DangKhoa2210/Digital-Microfluidics/Kicad Library/KiCadLibrary/arduino_micro_shield-master/README.md

arduino_micro_shield
====================

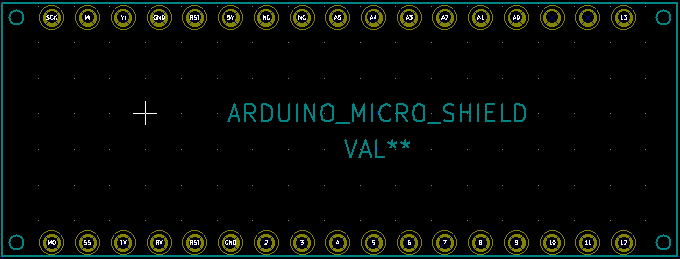
[picture p1: Kicad Library/KiCadLibrary/arduino_micro_shield-master/arduino_micro_shield.png]
My image


KiCAD library and footprint for an Arduino Micro shield.

This is a component which represent the Arduino Micro pinout,
and a footprint for that component which maps to the surface area
and pinout of the Micro.

Pull requests very welcome!
