DangKhoa2210/Digital-Microfluidics/DMF_V2/Electronics/1. Mainboard/Mainboard_V2.kicad_pcb

## KiCad design DMF_V2/Electronics/1. Mainboard/Mainboard_V2.kicad_pcb (2025-07-13)

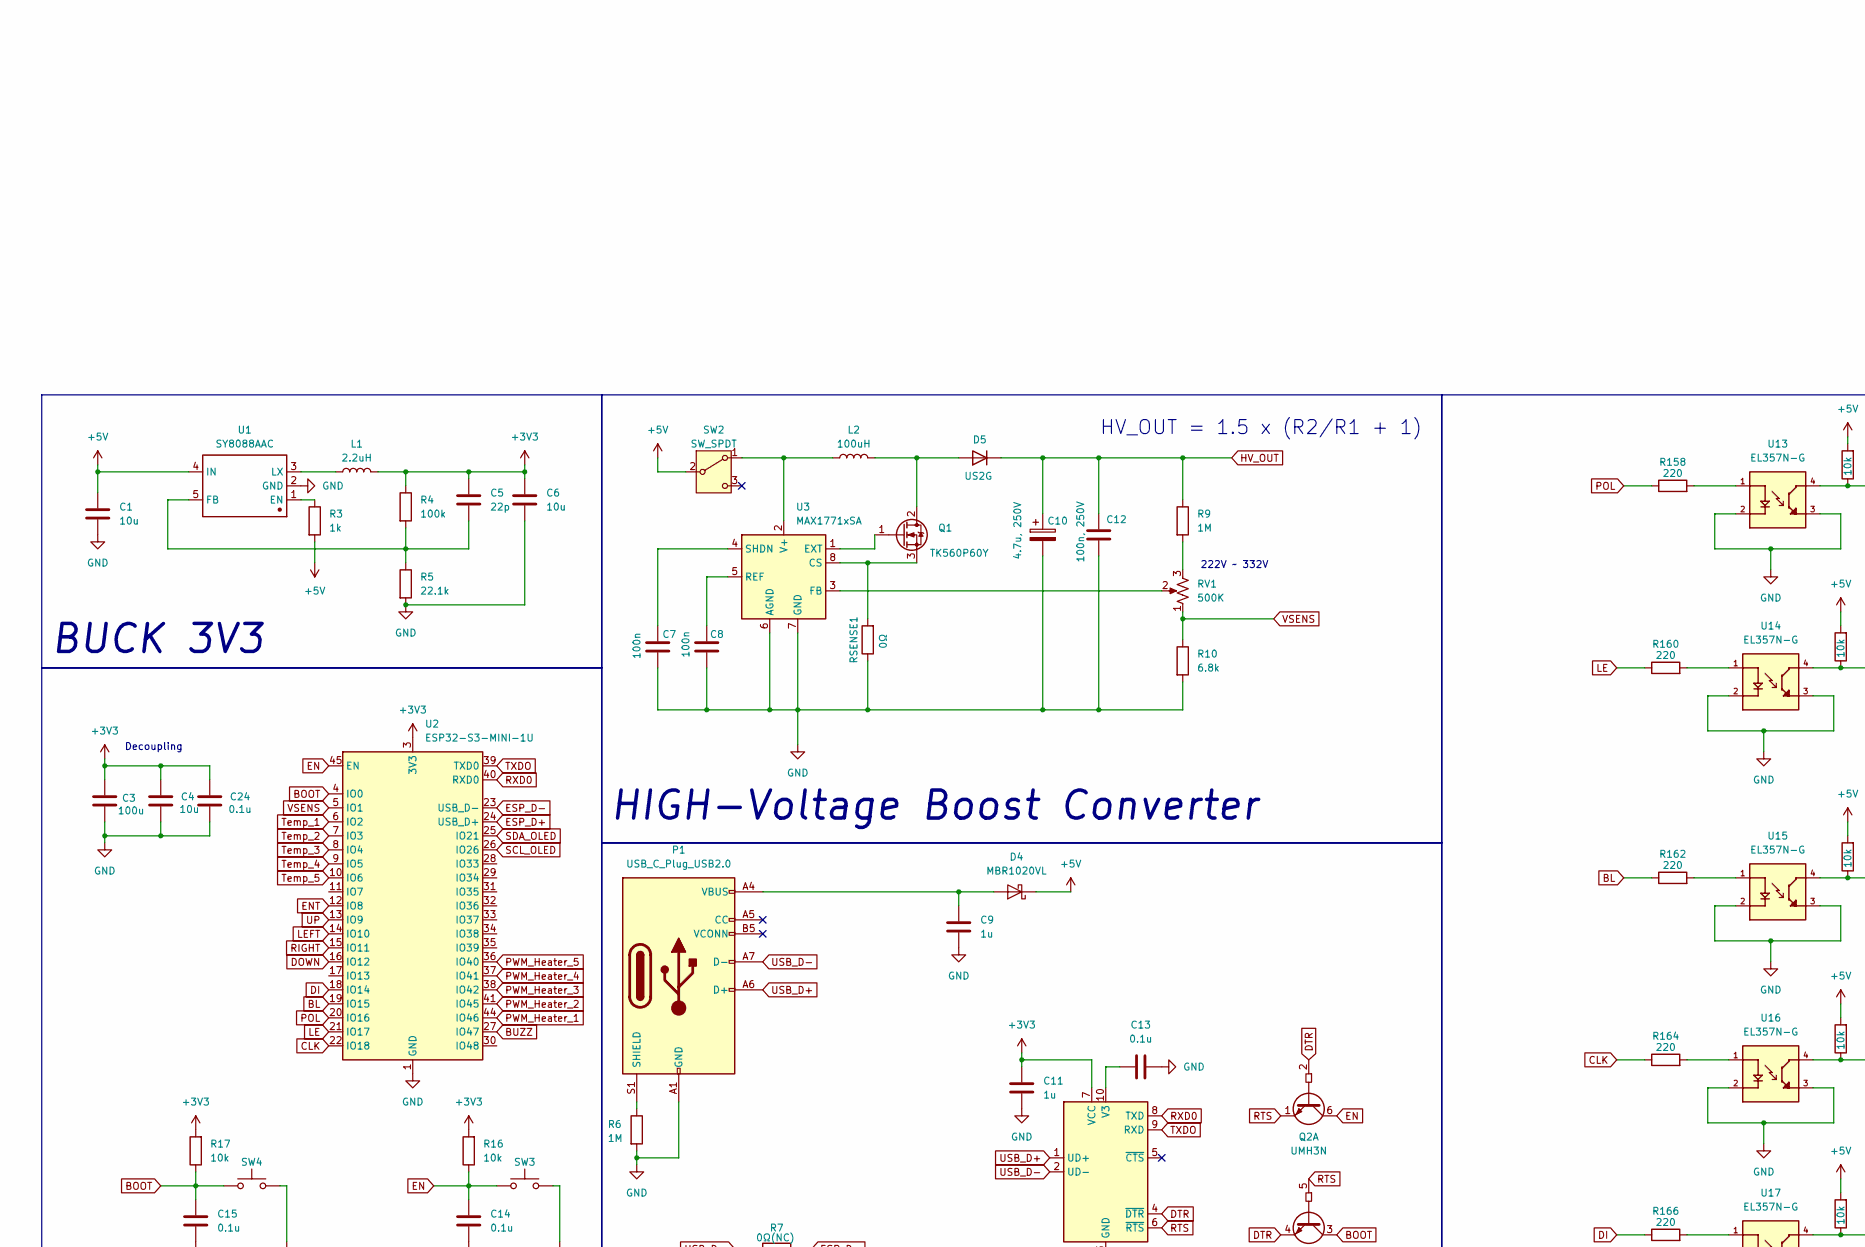
[picture p2: schematic Mainboard_V2.kicad_sch, part in row 1, column 1]

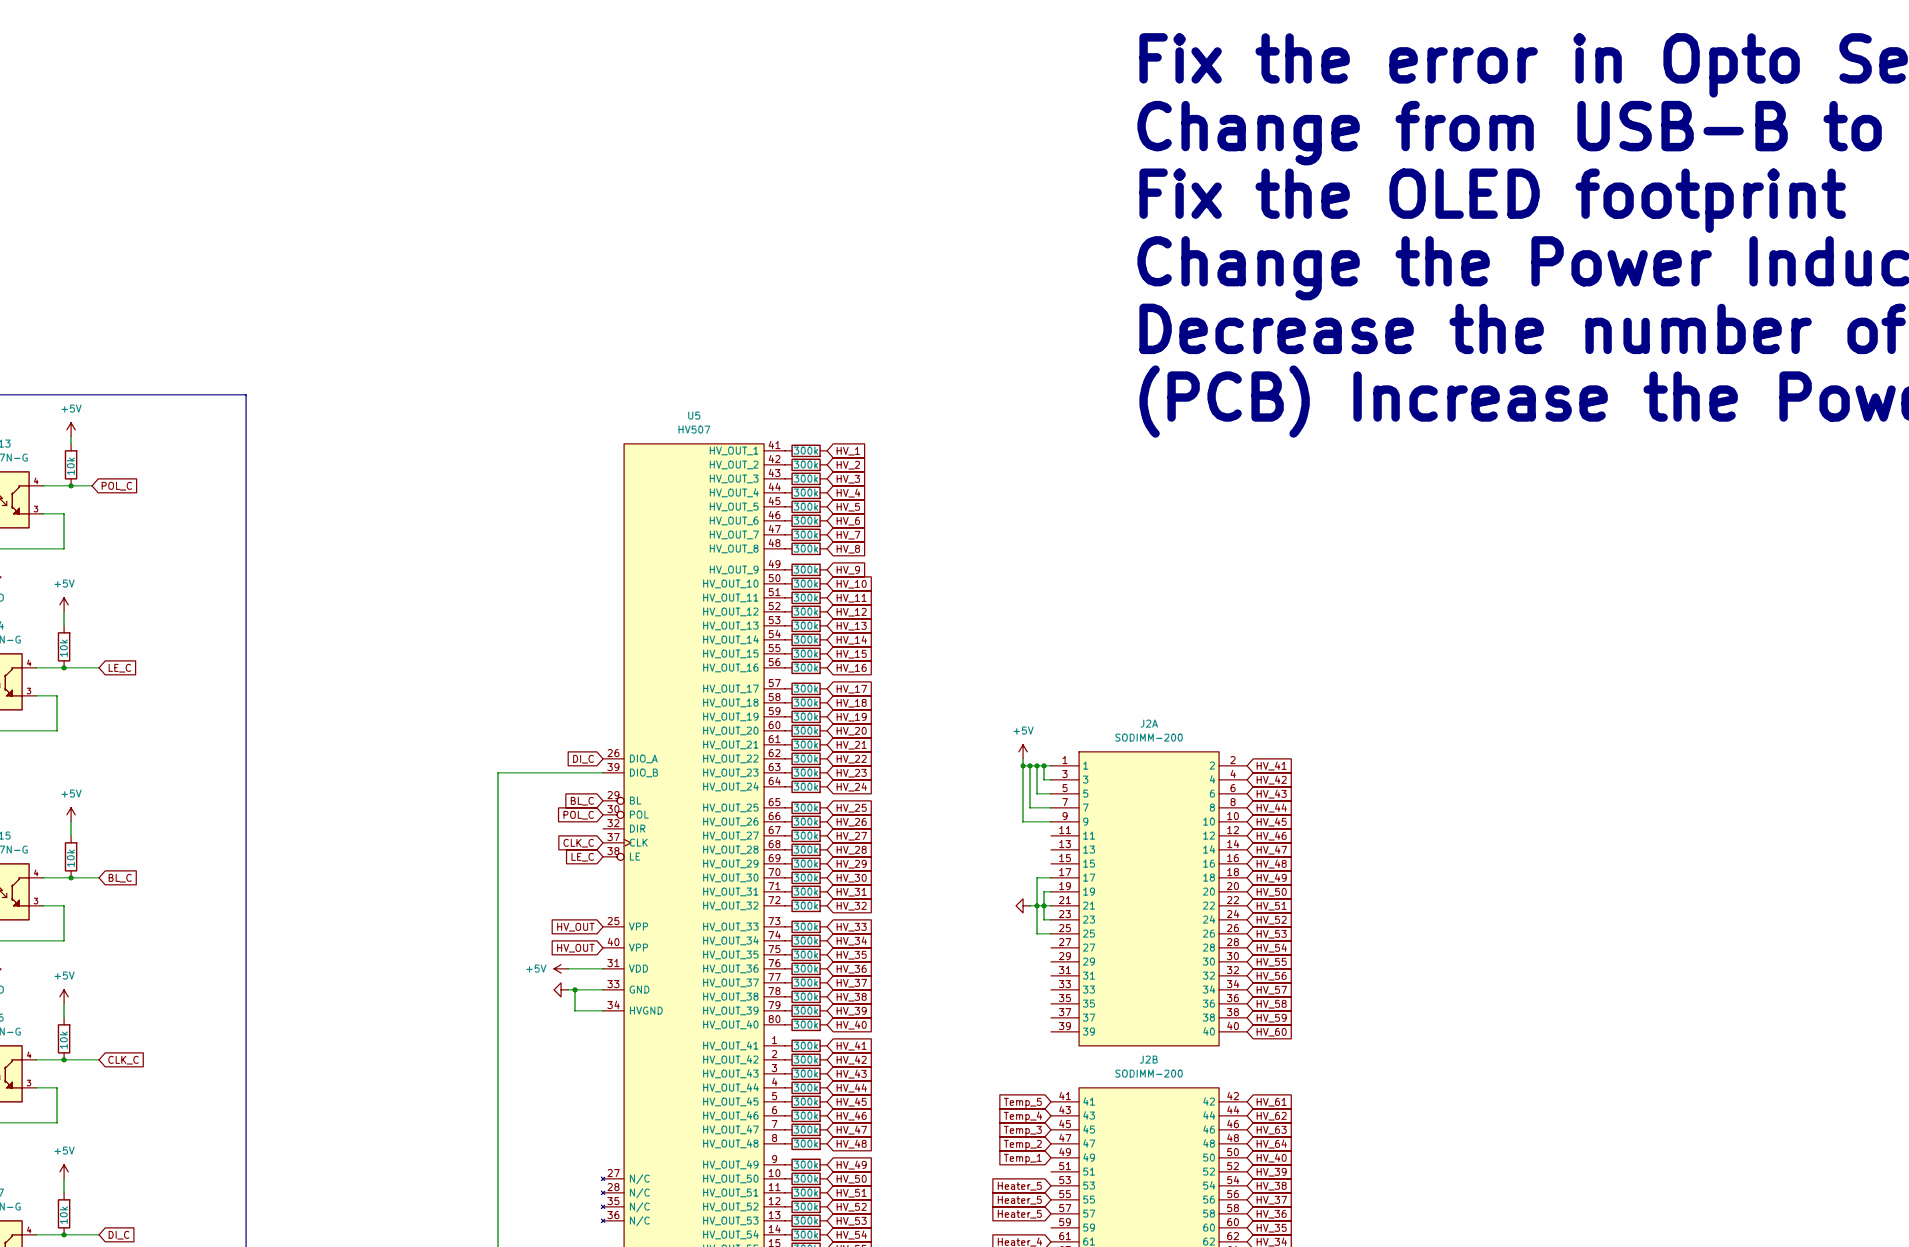
[picture p3: schematic Mainboard_V2.kicad_sch, part in row 1, column 2]

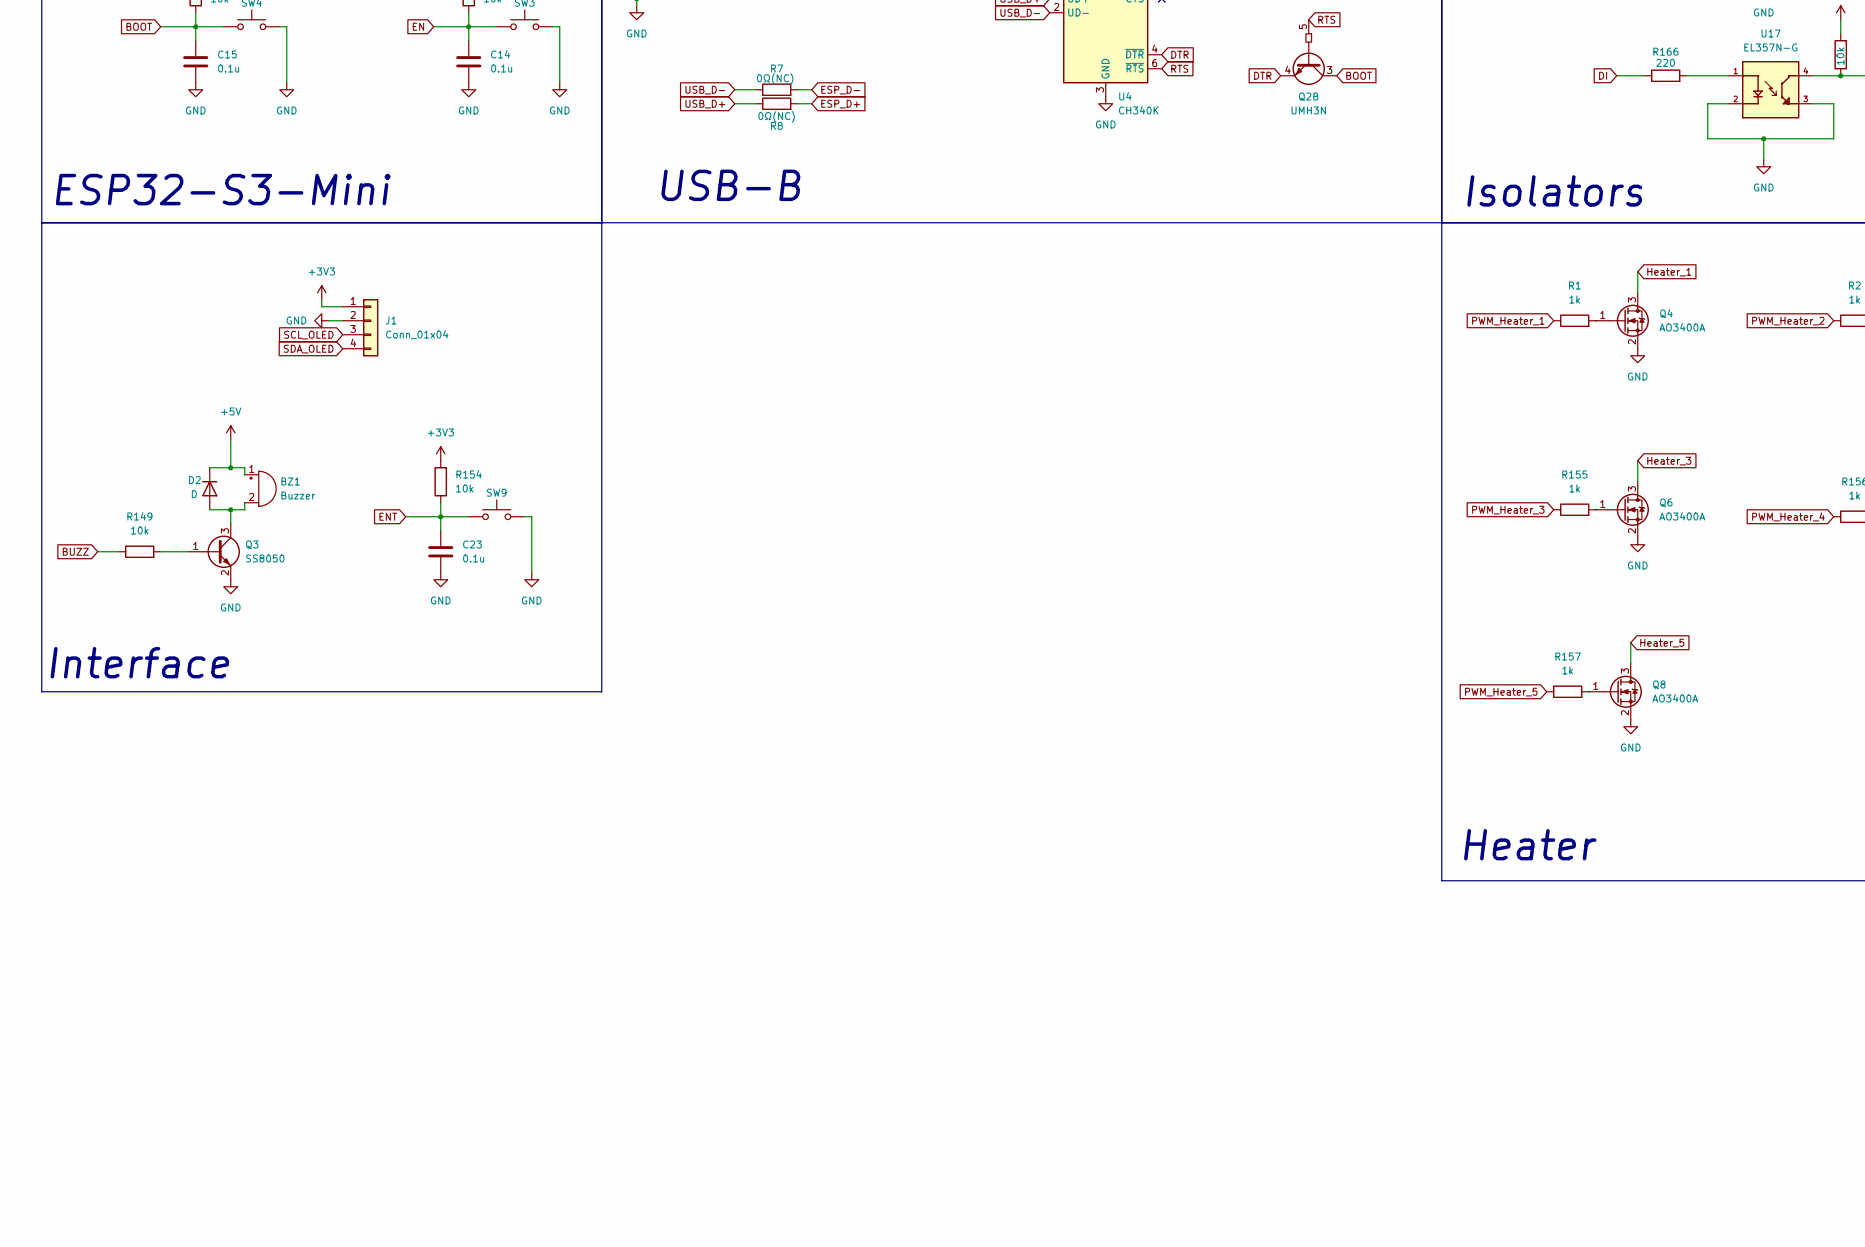
[picture p4: schematic Mainboard_V2.kicad_sch, part in row 2, column 1]

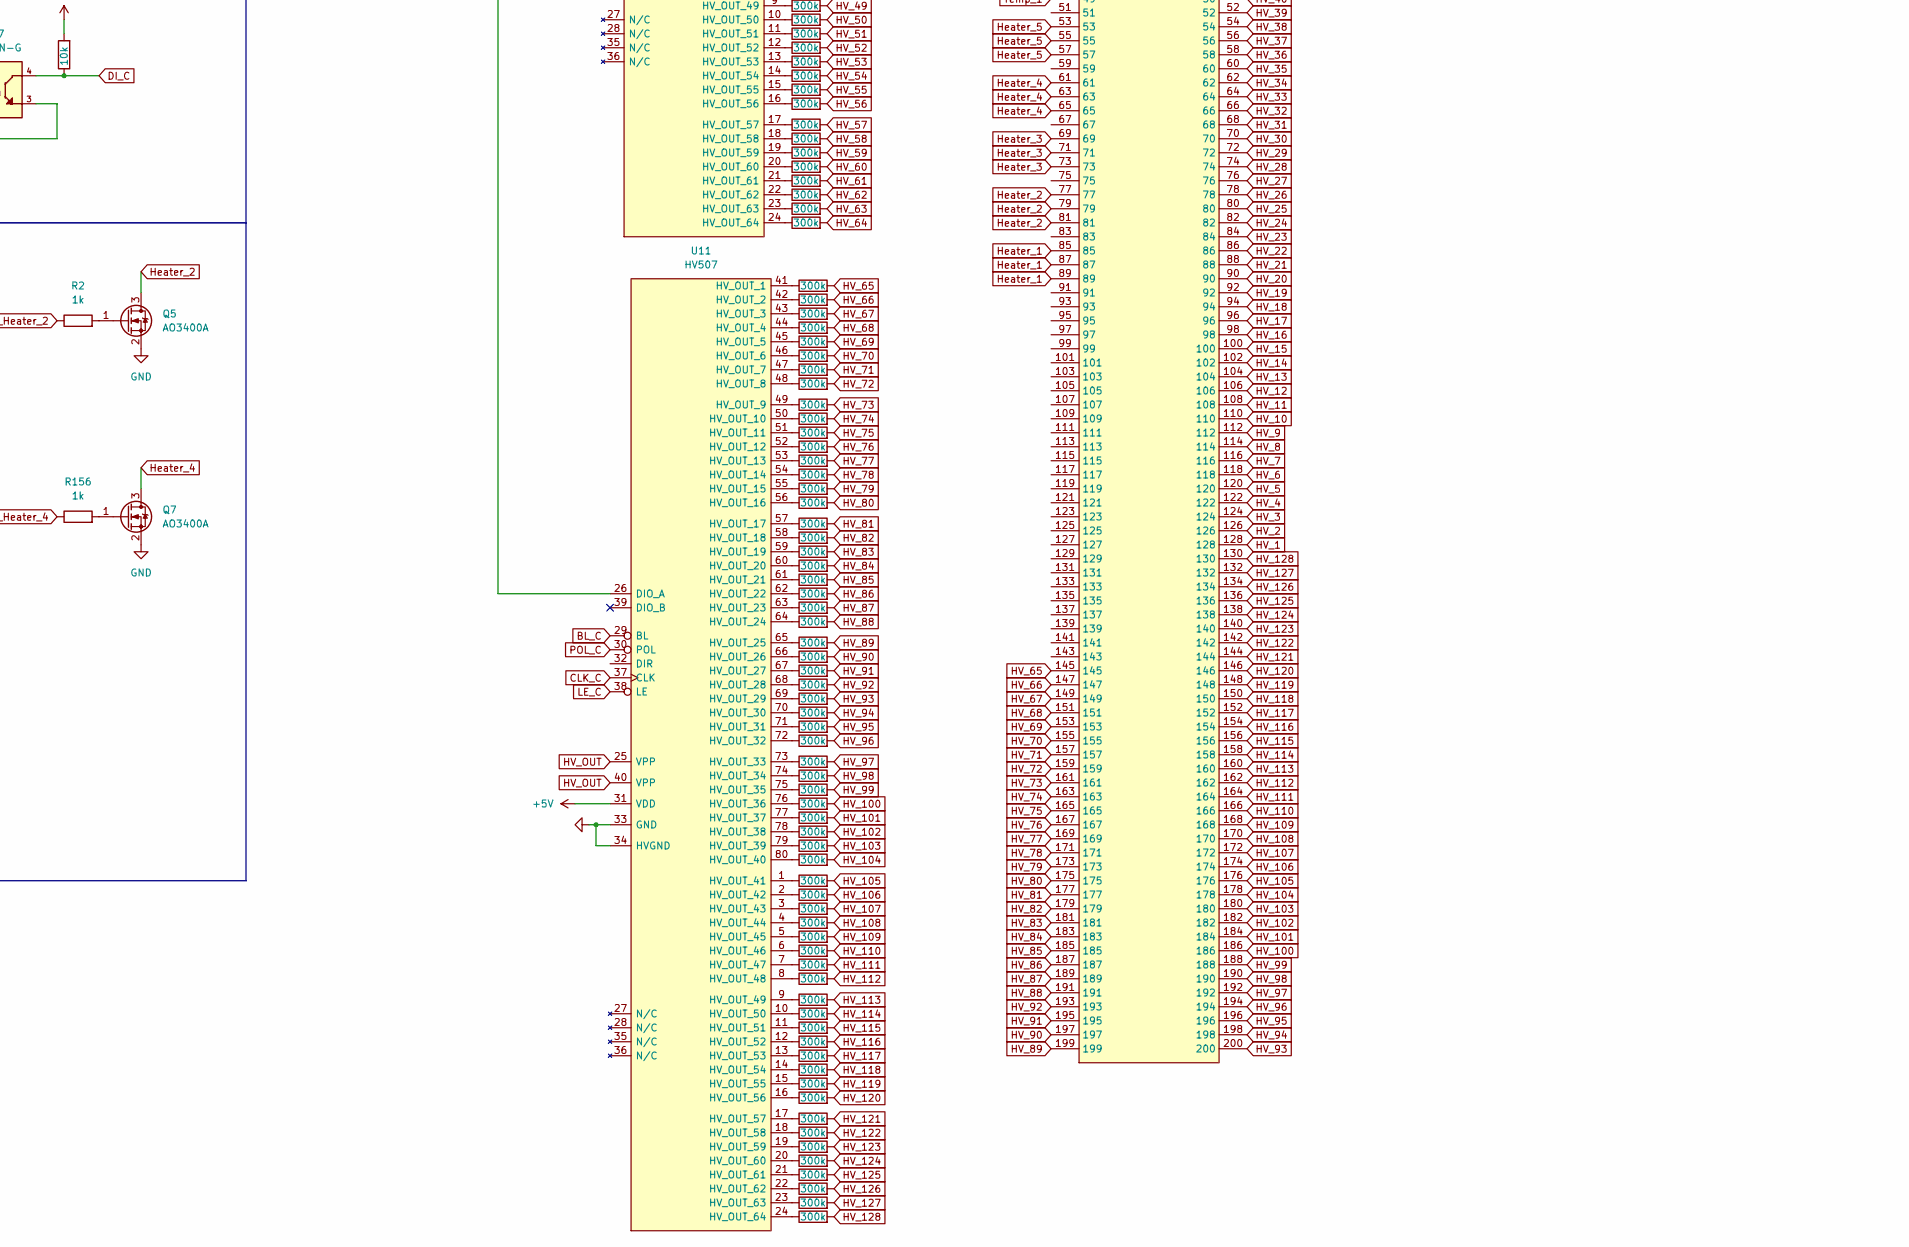
[picture p5: schematic Mainboard_V2.kicad_sch, part in row 2, column 2]

Parts:
BZ1: Buzzer; Buzzer_12x9.5RM7.6
C1, C4, C6: 10u; C_0402_1005Metric
C3: 100u; C_0402_1005Metric
C5: 22p; C_0402_1005Metric
C7, C8: 100n; C_0402_1005Metric
C9, C11: 1u; C_0402_1005Metric
C10: 4.7u, 250V; CP_Radial_D8.0mm_P3.50mm
C12: 100n, 250V; C_Rect_L13.0mm_W6.5mm_P7.50mm_P10.00mm
C13, C14, C15, C23, C24: 0.1u; C_0402_1005Metric
D2: D; D_0201_0603Metric
D4: MBR1020VL; D_SOD-123F
D5: US2G; D_SMB
J1: Conn_01x04; FanPinHeader_1x04_P2.54mm_Vertical
J2: SODIMM-200; SO-DIMM
L1: 2.2uH; PowerInductor_CYA0630-2.2UH
L2: 100uH; PowerInductor_CYA0630-2.2UH
P1: USB_C_Plug_USB2.0; USB_C_Receptacle_Amphenol_124019772112A
Q1: TK560P60Y; TO-252-2
Q2: UMH3N; SOT-363_SC-70-6
Q3: SS8050; SOT-23
Q4, Q5, Q6, Q7, Q8: AO3400A; SOT-23
R1, R2, R3, R155, R156, R157: 1k; R_0402_1005Metric
R4: 100k; R_0402_1005Metric
R5: 22.1k; R_0402_1005Metric
R6: 1M; R_0402_1005Metric
R7, R8: 0Ω(NC); R_0402_1005Metric
R9: 1M; R_0805_2012Metric
R10: 6.8k; R_0402_1005Metric
R16, R17, R149, R154, R159, R161, R163, R165, R167: 10k; R_0402_1005Metric
R20, R21, R22, R23, R24, R25, R26, R27, R28, R29, R30, R31, R32, R33, R34, R35, R36, R37, R38, R39, R40, R41, R42, R43, R44, R45, R46, R47, R48, R49, R50, R51, R52, R53, R54, R55, R56, R57, R58, R59, R60, R61, R62, R63, R64, R65, R66, R67, R68, R69, R70, R71, R72, R73, R74, R75, R76, R77, R78, R79, R80, R81, R82, R83, R84, R85, R86, R87, R88, R89, R90, R91, R92, R93, R94, R95, R96, R97, R98, R99, R100, R101, R102, R103, R104, R105, R106, R107, R108, R109, R110, R111, R112, R113, R114, R115, R116, R117, R118, R119, R120, R121, R122, R123, R124, R125, R126, R127, R128, R129, R130, R131, R132, R133, R134, R135, R136, R137, R138, R139, R140, R141, R142, R143, R144, R145, R146, R147: 300k; R_0402_1005Metric
R158, R160, R162, R164, R166: 220; R_0402_1005Metric
RSENSE1: 0Ω; R_0402_1005Metric
RV1: 500K; Potentiometer_Bourns_3296W_Vertical
SW2: SW_SPDT; SW_Slide-03_Wuerth-WS-SLTV_10x2.5x6.4_P2.54mm
SW3, SW4, SW9: SW_Push; SW_SPST_TL3342
U1: SY8088AAC; SY8088
U2: ESP32-S3-MINI-1U; ESP32-S2-MINI-1
U3: MAX1771xSA; SO-8_3.9x4.9mm_P1.27mm
U4: CH340K; SSOP-10-1EP_3.9x4.9mm_P1mm_EP2.1x3.3mm
U5, U11: HV507; HV507PG-G
U13, U14, U15, U16, U17: EL357N-G; OPTO_EL357N-G; PARTREV 6

Connections:
+3V3: C3.1, C4.1, C5.1, C6.1, C11.1, C24.1, J1.1, L1.2, R4.1, R16.2, R17.2, R154.2, U2.3 (3V3), U4.7 (VCC)
+5V: BZ1.1 (+), C1.1, D2.1 (K), D4.1 (K), J2.1, J2.3, J2.5, J2.7, J2.9, R3.2, R159.2, R161.2, R163.2, R165.2, R167.2, SW2.2 (B), U1.4 (IN), U5.31 (VDD), U11.31 (VDD)
BL: R162.1, U2.19 (IO15)
BL_C: R163.1, U5.29 (BL), U11.29 (BL), U15.4
BOOT: C15.1, Q2.3 (C2), R17.1, SW4.1, U2.4 (IO0)
BUZZ: R149.1, U2.27 (IO47)
CLK: R164.1, U2.22 (IO18)
CLK_C: R165.1, U5.37 (CLK), U11.37 (CLK), U16.4
DI: R166.1, U2.18 (IO14)
DI_C: R167.1, U5.26 (DIO_A), U17.4
DOWN: U2.16 (IO12)
DTR: Q2.2 (B1), Q2.4 (E2), U4.4 (~DTR)
EN: C14.1, Q2.6 (C1), R16.1, SW3.1, U2.45 (EN)
ENT: C23.1, R154.1, SW9.1, U2.12 (IO8)
ESP_D+: R8.2, U2.24 (USB_D+)
ESP_D-: R7.2, U2.23 (USB_D-)
GND: C1.2, C3.2, C4.2, C6.2, C7.2, C8.2, C9.2, C10.2, C11.2, C12.2, C13.2, C14.2, C15.2, C23.2, C24.2, J1.2, J2.17, J2.19, J2.21, J2.23, J2.25, P1.A1 (GND), P1.A12 (GND), P1.B1 (GND), P1.B12 (GND), Q3.2 (E), Q4.2 (S), Q5.2 (S), Q6.2 (S), Q7.2 (S), Q8.2 (S), R5.2, R6.2, R10.2, RSENSE1.1, SW3.2, SW4.2, SW9.2, U1.2 (GND), U2.1 (GND), U2.2 (GND), U2.42 (GND), U2.43 (GND), U2.46 (GND), U2.47 (GND), U2.48 (GND), U2.49 (GND), U2.50 (GND), U2.51 (GND), U2.52 (GND), U2.53 (GND), U2.54 (GND), U2.55 (GND), U2.56 (GND), U2.57 (GND), U2.58 (GND), U2.59 (GND), U2.60 (GND), U2.61 (GND), U2.62 (GND), U2.63 (GND), U2.64 (GND), U2.65 (GND), U3.6 (AGND), U3.7 (GND), U4.3 (GND), U4.11 (GND), U5.33 (GND), U5.34 (HVGND), U11.33 (GND), U11.34 (HVGND), U13.2, U13.3, U14.2, U14.3, U15.2, U15.3, U16.2, U16.3, U17.2, U17.3
HV_1: J2.128, R20.2
HV_2: J2.126, R21.2
HV_3: J2.124, R22.2
HV_4: J2.122, R23.2
HV_5: J2.120, R24.2
HV_6: J2.118, R25.2
HV_7: J2.116, R26.2
HV_8: J2.114, R27.2
HV_9: J2.112, R28.2
HV_10: J2.110, R29.2
HV_11: J2.108, R30.2
HV_12: J2.106, R31.2
HV_13: J2.104, R32.2
HV_14: J2.102, R33.2
HV_15: J2.100, R34.2
HV_16: J2.98, R35.2
HV_17: J2.96, R36.2
HV_18: J2.94, R37.2
HV_19: J2.92, R38.2
HV_20: J2.90, R39.2
HV_21: J2.88, R40.2
HV_22: J2.86, R41.2
HV_23: J2.84, R42.2
HV_24: J2.82, R43.2
HV_25: J2.80, R44.2
HV_26: J2.78, R45.2
HV_27: J2.76, R46.2
HV_28: J2.74, R47.2
HV_29: J2.72, R48.2
HV_30: J2.70, R49.2
HV_31: J2.68, R50.2
HV_32: J2.66, R51.2
HV_33: J2.64, R52.2
HV_34: J2.62, R53.2
HV_35: J2.60, R54.2
HV_36: J2.58, R55.2
HV_37: J2.56, R56.2
HV_38: J2.54, R57.2
HV_39: J2.52, R58.2
HV_40: J2.50, R59.2
HV_41: J2.2, R60.2
HV_42: J2.4, R61.2
HV_43: J2.6, R62.2
HV_44: J2.8, R63.2
HV_45: J2.10, R64.2
HV_46: J2.12, R65.2
HV_47: J2.14, R66.2
HV_48: J2.16, R67.2
HV_49: J2.18, R68.2
HV_50: J2.20, R69.2
HV_51: J2.22, R70.2
HV_52: J2.24, R71.2
HV_53: J2.26, R72.2
HV_54: J2.28, R73.2
HV_55: J2.30, R74.2
HV_56: J2.32, R75.2
HV_57: J2.34, R76.2
HV_58: J2.36, R77.2
HV_59: J2.38, R78.2
HV_60: J2.40, R79.2
HV_61: J2.42, R80.2
HV_62: J2.44, R81.2
HV_63: J2.46, R82.2
HV_64: J2.48, R83.2
HV_65: J2.145, R84.2
HV_66: J2.147, R85.2
HV_67: J2.149, R86.2
HV_68: J2.151, R87.2
HV_69: J2.153, R88.2
HV_70: J2.155, R89.2
HV_71: J2.157, R90.2
HV_72: J2.159, R91.2
HV_73: J2.161, R92.2
HV_74: J2.163, R93.2
HV_75: J2.165, R94.2
HV_76: J2.167, R95.2
HV_77: J2.169, R96.2
HV_78: J2.171, R97.2
HV_79: J2.173, R98.2
HV_80: J2.175, R99.2
HV_81: J2.177, R100.2
HV_82: J2.179, R101.2
HV_83: J2.181, R102.2
HV_84: J2.183, R103.2
HV_85: J2.185, R104.2
HV_86: J2.187, R105.2
HV_87: J2.189, R106.2
HV_88: J2.191, R107.2
HV_89: J2.199, R108.2
HV_90: J2.197, R109.2
HV_91: J2.195, R110.2
HV_92: J2.193, R111.2
HV_93: J2.200, R112.2
HV_94: J2.198, R113.2
HV_95: J2.196, R114.2
HV_96: J2.194, R115.2
HV_97: J2.192, R116.2
HV_98: J2.190, R117.2
HV_99: J2.188, R118.2
HV_100: J2.186, R119.2
HV_101: J2.184, R120.2
HV_102: J2.182, R121.2
HV_103: J2.180, R122.2
HV_104: J2.178, R123.2
HV_105: J2.176, R124.2
HV_106: J2.174, R125.2
HV_107: J2.172, R126.2
HV_108: J2.170, R127.2
HV_109: J2.168, R128.2
HV_110: J2.166, R129.2
HV_111: J2.164, R130.2
HV_112: J2.162, R131.2
HV_113: J2.160, R132.2
HV_114: J2.158, R133.2
HV_115: J2.156, R134.2
HV_116: J2.154, R135.2
HV_117: J2.152, R136.2
HV_118: J2.150, R137.2
HV_119: J2.148, R138.2
HV_120: J2.146, R139.2
HV_121: J2.144, R140.2
HV_122: J2.142, R141.2
HV_123: J2.140, R142.2
HV_124: J2.138, R143.2
HV_125: J2.136, R144.2
HV_126: J2.134, R145.2
HV_127: J2.132, R146.2
HV_128: J2.130, R147.2
HV_OUT: C10.1, C12.1, D5.1 (K), R9.1, U5.25 (VPP), U5.40 (VPP), U11.25 (VPP), U11.40 (VPP)
Heater_1: J2.85, J2.87, J2.89, Q4.3 (D)
Heater_2: J2.77, J2.79, J2.81, Q5.3 (D)
Heater_3: J2.69, J2.71, J2.73, Q6.3 (D)
Heater_4: J2.61, J2.63, J2.65, Q7.3 (D)
Heater_5: J2.53, J2.55, J2.57, Q8.3 (D)
LE: R160.1, U2.21 (IO17)
LEFT: U2.14 (IO10)
LE_C: R161.1, U5.38 (LE), U11.38 (LE), U14.4
unnamed: BZ1.2 (-), D2.2 (A), Q3.3 (C)
unnamed: C9.1, D4.2 (A), P1.A4 (VBUS), P1.A9 (VBUS), P1.B4 (VBUS), P1.B9 (VBUS)
unnamed: D5.2 (A), L2.2, Q1.2 (D)
unnamed: P1.S1 (SHIELD), R6.1
unnamed: Q1.1 (G), U3.1 (EXT)
unnamed: Q1.3 (S), RSENSE1.2, U3.8 (CS)
unnamed: Q3.1 (B), R149.2
unnamed: Q4.1 (G), R1.2
unnamed: Q5.1 (G), R2.2
unnamed: Q6.1 (G), R155.2
unnamed: Q7.1 (G), R156.2
unnamed: Q8.1 (G), R157.2
unnamed: R9.2, RV1.3
unnamed: R158.2, U13.1
unnamed: R160.2, U14.1
unnamed: R162.2, U15.1
unnamed: R164.2, U16.1
unnamed: R166.2, U17.1
unnamed: L2.1, SW2.1 (A), U3.2 (V+)
unnamed: R3.1, U1.1 (EN)
unnamed: C5.2, R4.2, R5.1, U1.5 (FB)
unnamed: L1.1, U1.3 (LX)
unnamed: RV1.2, U3.3 (FB)
unnamed: C8.1, U3.5 (REF)
unnamed: C7.1, U3.4 (SHDN)
unnamed: C13.1, U4.10 (V3)
unnamed: R20.1, U5.41 (HV_OUT_1)
unnamed: R21.1, U5.42 (HV_OUT_2)
unnamed: R22.1, U5.43 (HV_OUT_3)
unnamed: R23.1, U5.44 (HV_OUT_4)
unnamed: R24.1, U5.45 (HV_OUT_5)
unnamed: R25.1, U5.46 (HV_OUT_6)
unnamed: R26.1, U5.47 (HV_OUT_7)
unnamed: R27.1, U5.48 (HV_OUT_8)
unnamed: R28.1, U5.49 (HV_OUT_9)
unnamed: R29.1, U5.50 (HV_OUT_10)
unnamed: R30.1, U5.51 (HV_OUT_11)
unnamed: R31.1, U5.52 (HV_OUT_12)
unnamed: R32.1, U5.53 (HV_OUT_13)
unnamed: R33.1, U5.54 (HV_OUT_14)
unnamed: R34.1, U5.55 (HV_OUT_15)
unnamed: R35.1, U5.56 (HV_OUT_16)
unnamed: R36.1, U5.57 (HV_OUT_17)
unnamed: R37.1, U5.58 (HV_OUT_18)
unnamed: R38.1, U5.59 (HV_OUT_19)
unnamed: R39.1, U5.60 (HV_OUT_20)
unnamed: R40.1, U5.61 (HV_OUT_21)
unnamed: R41.1, U5.62 (HV_OUT_22)
unnamed: R42.1, U5.63 (HV_OUT_23)
unnamed: R43.1, U5.64 (HV_OUT_24)
unnamed: R44.1, U5.65 (HV_OUT_25)
unnamed: R45.1, U5.66 (HV_OUT_26)
unnamed: R46.1, U5.67 (HV_OUT_27)
unnamed: R47.1, U5.68 (HV_OUT_28)
unnamed: R48.1, U5.69 (HV_OUT_29)
unnamed: R49.1, U5.70 (HV_OUT_30)
unnamed: R50.1, U5.71 (HV_OUT_31)
unnamed: R51.1, U5.72 (HV_OUT_32)
unnamed: R52.1, U5.73 (HV_OUT_33)
unnamed: R53.1, U5.74 (HV_OUT_34)
unnamed: R54.1, U5.75 (HV_OUT_35)
unnamed: R55.1, U5.76 (HV_OUT_36)
unnamed: R56.1, U5.77 (HV_OUT_37)
unnamed: R57.1, U5.78 (HV_OUT_38)
unnamed: R58.1, U5.79 (HV_OUT_39)
unnamed: R59.1, U5.80 (HV_OUT_40)
unnamed: R60.1, U5.1 (HV_OUT_41)
unnamed: R61.1, U5.2 (HV_OUT_42)
unnamed: R62.1, U5.3 (HV_OUT_43)
unnamed: R63.1, U5.4 (HV_OUT_44)
unnamed: R64.1, U5.5 (HV_OUT_45)
unnamed: R65.1, U5.6 (HV_OUT_46)
unnamed: R66.1, U5.7 (HV_OUT_47)
unnamed: R67.1, U5.8 (HV_OUT_48)
unnamed: R68.1, U5.9 (HV_OUT_49)
unnamed: R69.1, U5.10 (HV_OUT_50)
unnamed: R70.1, U5.11 (HV_OUT_51)
unnamed: R71.1, U5.12 (HV_OUT_52)
unnamed: R72.1, U5.13 (HV_OUT_53)
unnamed: R73.1, U5.14 (HV_OUT_54)
unnamed: R74.1, U5.15 (HV_OUT_55)
unnamed: R75.1, U5.16 (HV_OUT_56)
unnamed: R76.1, U5.17 (HV_OUT_57)
unnamed: R77.1, U5.18 (HV_OUT_58)
unnamed: R78.1, U5.19 (HV_OUT_59)
unnamed: R79.1, U5.20 (HV_OUT_60)
unnamed: R80.1, U5.21 (HV_OUT_61)
unnamed: R81.1, U5.22 (HV_OUT_62)
unnamed: R82.1, U5.23 (HV_OUT_63)
unnamed: R83.1, U5.24 (HV_OUT_64)
unnamed: U5.39 (DIO_B), U11.26 (DIO_A)
unnamed: R84.1, U11.41 (HV_OUT_1)
unnamed: R85.1, U11.42 (HV_OUT_2)
unnamed: R86.1, U11.43 (HV_OUT_3)
unnamed: R87.1, U11.44 (HV_OUT_4)
unnamed: R88.1, U11.45 (HV_OUT_5)
unnamed: R89.1, U11.46 (HV_OUT_6)
unnamed: R90.1, U11.47 (HV_OUT_7)
unnamed: R91.1, U11.48 (HV_OUT_8)
unnamed: R92.1, U11.49 (HV_OUT_9)
unnamed: R93.1, U11.50 (HV_OUT_10)
unnamed: R94.1, U11.51 (HV_OUT_11)
unnamed: R95.1, U11.52 (HV_OUT_12)
unnamed: R96.1, U11.53 (HV_OUT_13)
unnamed: R97.1, U11.54 (HV_OUT_14)
unnamed: R98.1, U11.55 (HV_OUT_15)
unnamed: R99.1, U11.56 (HV_OUT_16)
unnamed: R100.1, U11.57 (HV_OUT_17)
unnamed: R101.1, U11.58 (HV_OUT_18)
unnamed: R102.1, U11.59 (HV_OUT_19)
unnamed: R103.1, U11.60 (HV_OUT_20)
unnamed: R104.1, U11.61 (HV_OUT_21)
unnamed: R105.1, U11.62 (HV_OUT_22)
unnamed: R106.1, U11.63 (HV_OUT_23)
unnamed: R107.1, U11.64 (HV_OUT_24)
unnamed: R108.1, U11.65 (HV_OUT_25)
unnamed: R109.1, U11.66 (HV_OUT_26)
unnamed: R110.1, U11.67 (HV_OUT_27)
unnamed: R111.1, U11.68 (HV_OUT_28)
unnamed: R112.1, U11.69 (HV_OUT_29)
unnamed: R113.1, U11.70 (HV_OUT_30)
unnamed: R114.1, U11.71 (HV_OUT_31)
unnamed: R115.1, U11.72 (HV_OUT_32)
unnamed: R116.1, U11.73 (HV_OUT_33)
unnamed: R117.1, U11.74 (HV_OUT_34)
unnamed: R118.1, U11.75 (HV_OUT_35)
unnamed: R119.1, U11.76 (HV_OUT_36)
unnamed: R120.1, U11.77 (HV_OUT_37)
unnamed: R121.1, U11.78 (HV_OUT_38)
unnamed: R122.1, U11.79 (HV_OUT_39)
unnamed: R123.1, U11.80 (HV_OUT_40)
unnamed: R124.1, U11.1 (HV_OUT_41)
unnamed: R125.1, U11.2 (HV_OUT_42)
unnamed: R126.1, U11.3 (HV_OUT_43)
unnamed: R127.1, U11.4 (HV_OUT_44)
unnamed: R128.1, U11.5 (HV_OUT_45)
unnamed: R129.1, U11.6 (HV_OUT_46)
unnamed: R130.1, U11.7 (HV_OUT_47)
unnamed: R131.1, U11.8 (HV_OUT_48)
unnamed: R132.1, U11.9 (HV_OUT_49)
unnamed: R133.1, U11.10 (HV_OUT_50)
unnamed: R134.1, U11.11 (HV_OUT_51)
unnamed: R135.1, U11.12 (HV_OUT_52)
unnamed: R136.1, U11.13 (HV_OUT_53)
unnamed: R137.1, U11.14 (HV_OUT_54)
unnamed: R138.1, U11.15 (HV_OUT_55)
unnamed: R139.1, U11.16 (HV_OUT_56)
unnamed: R140.1, U11.17 (HV_OUT_57)
unnamed: R141.1, U11.18 (HV_OUT_58)
unnamed: R142.1, U11.19 (HV_OUT_59)
unnamed: R143.1, U11.20 (HV_OUT_60)
unnamed: R144.1, U11.21 (HV_OUT_61)
unnamed: R145.1, U11.22 (HV_OUT_62)
unnamed: R146.1, U11.23 (HV_OUT_63)
unnamed: R147.1, U11.24 (HV_OUT_64)
POL: R158.1, U2.20 (IO16)
POL_C: R159.1, U5.30 (POL), U11.30 (POL), U13.4
PWM_Heater_1: R1.1, U2.44 (IO46)
PWM_Heater_2: R2.1, U2.41 (IO45)
PWM_Heater_3: R155.1, U2.38 (IO42)
PWM_Heater_4: R156.1, U2.37 (IO41)
PWM_Heater_5: R157.1, U2.36 (IO40)
RIGHT: U2.15 (IO11)
RTS: Q2.1 (E1), Q2.5 (B2), U4.6 (~RTS)
RXD0: U2.40 (RXD0), U4.8 (TXD)
SCL_OLED: J1.3, U2.26 (IO26)
SDA_OLED: J1.4, U2.25 (IO21)
TXDO: U2.39 (TXD0), U4.9 (RXD)
Temp_1: J2.49, U2.6 (IO2)
Temp_2: J2.47, U2.7 (IO3)
Temp_3: J2.45, U2.8 (IO4)
Temp_4: J2.43, U2.9 (IO5)
Temp_5: J2.41, U2.10 (IO6)
UP: U2.13 (IO9)
USB_D+: P1.A6 (D+), R8.1, U4.1 (UD+)
USB_D-: P1.A7 (D-), R7.1, U4.2 (UD-)
VSENS: R10.1, RV1.1, U2.5 (IO1)

Notes on the sheet:
Heater
USB-B
Interface
Decoupling
HV_OUT = 1.5 x (R2/R1 + 1)
222V ~ 332V
Fix the error in Opto Series Change from USB-B to USB-C Fix the OLED footprint Change the Power Inductor footprint Decrease the number of Buttons, use smaller button's footprint (PCB) Increase the Power traces width
ESP32-S3-Mini
Isolators
BUCK 3V3
HIGH-Voltage Boost Converter

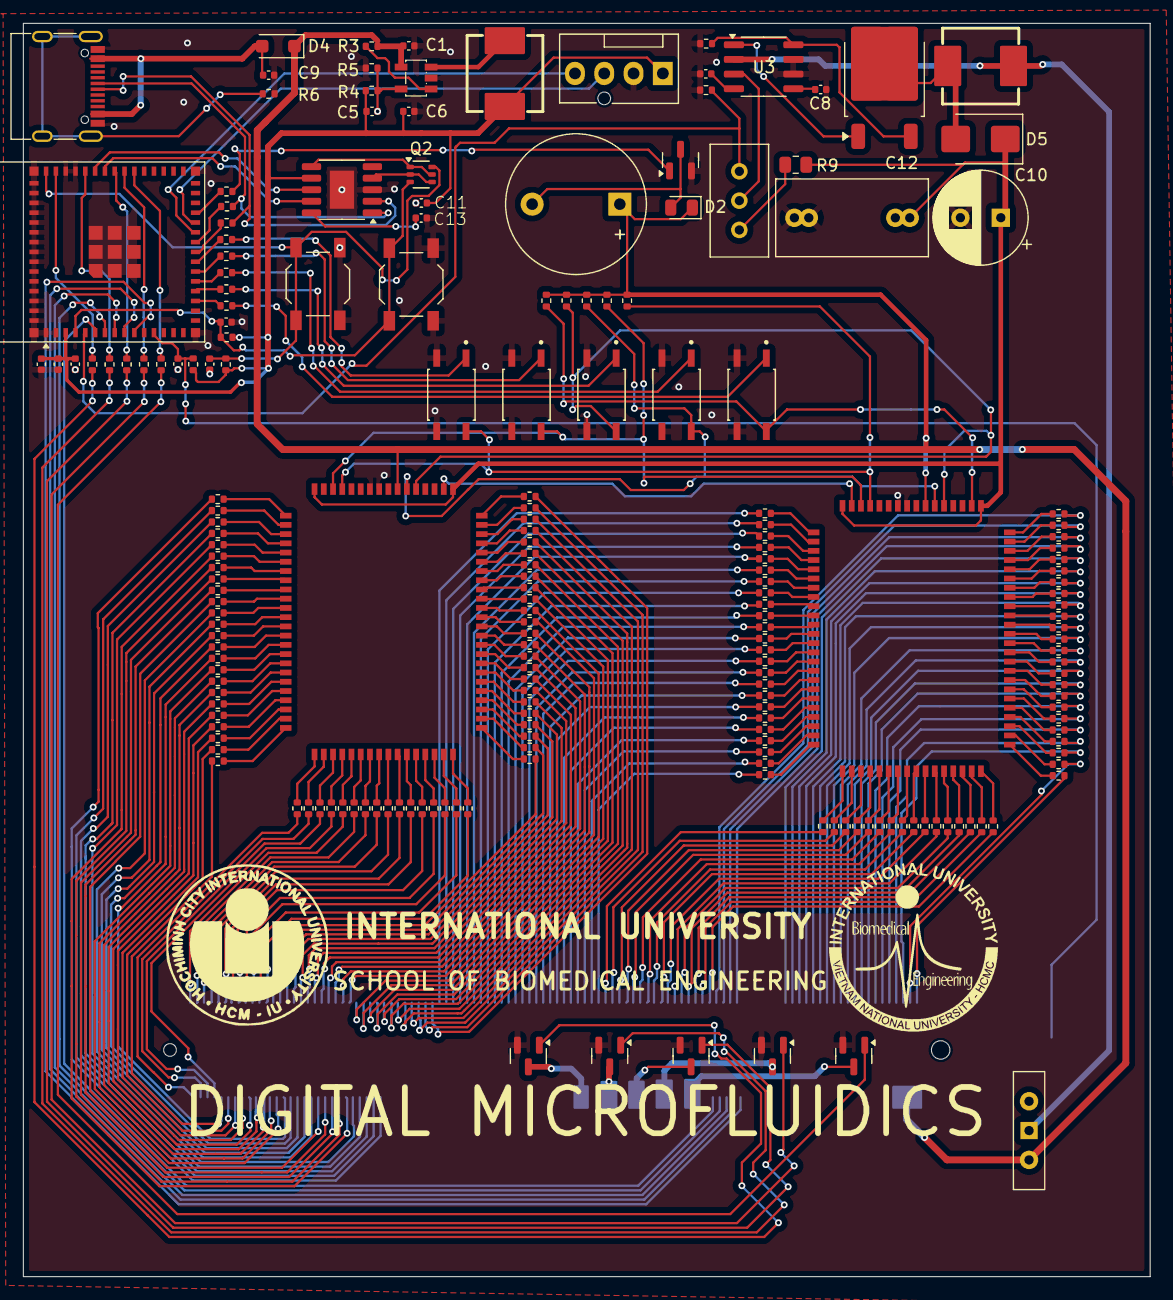
[picture p6: board Mainboard_V2.kicad_pcb from above]

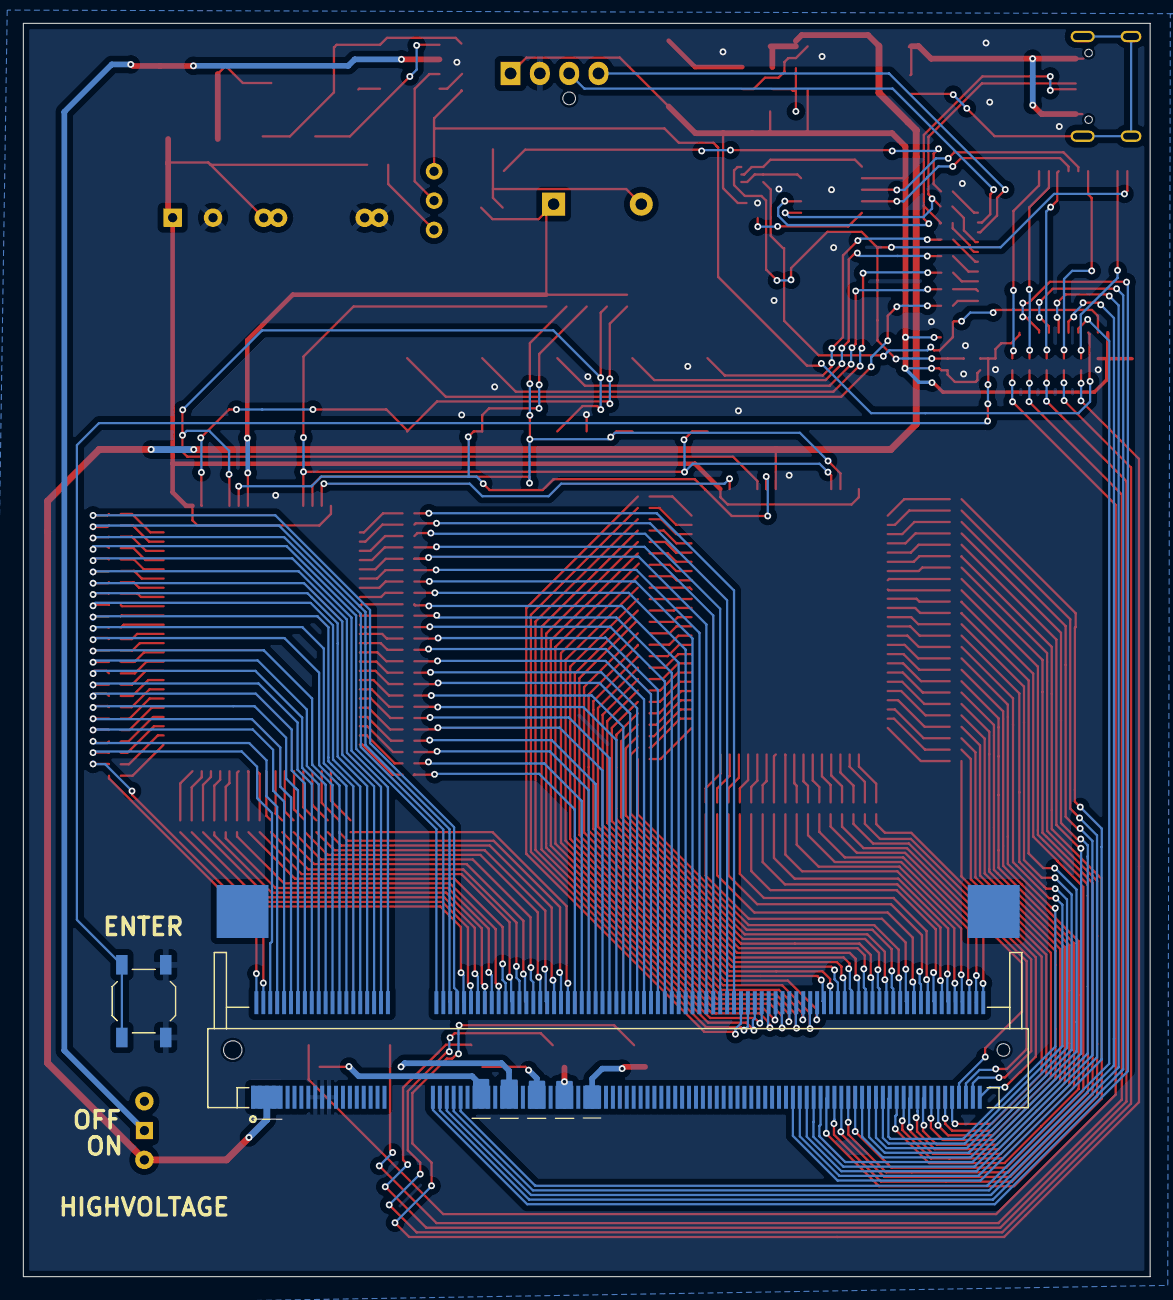
[picture p7: board Mainboard_V2.kicad_pcb from below]

Board: 2 copper layers, 97.7 x 108.6 mm, 205 parts (2 on the bottom side), 327 nets.
