DangKhoa2210/Digital-Microfluidics/DMF_V2/Electronics/2. Catridge/Cartridge.kicad_pcb

## KiCad design DMF_V2/Electronics/2. Catridge/Cartridge.kicad_pcb (2025-07-13)

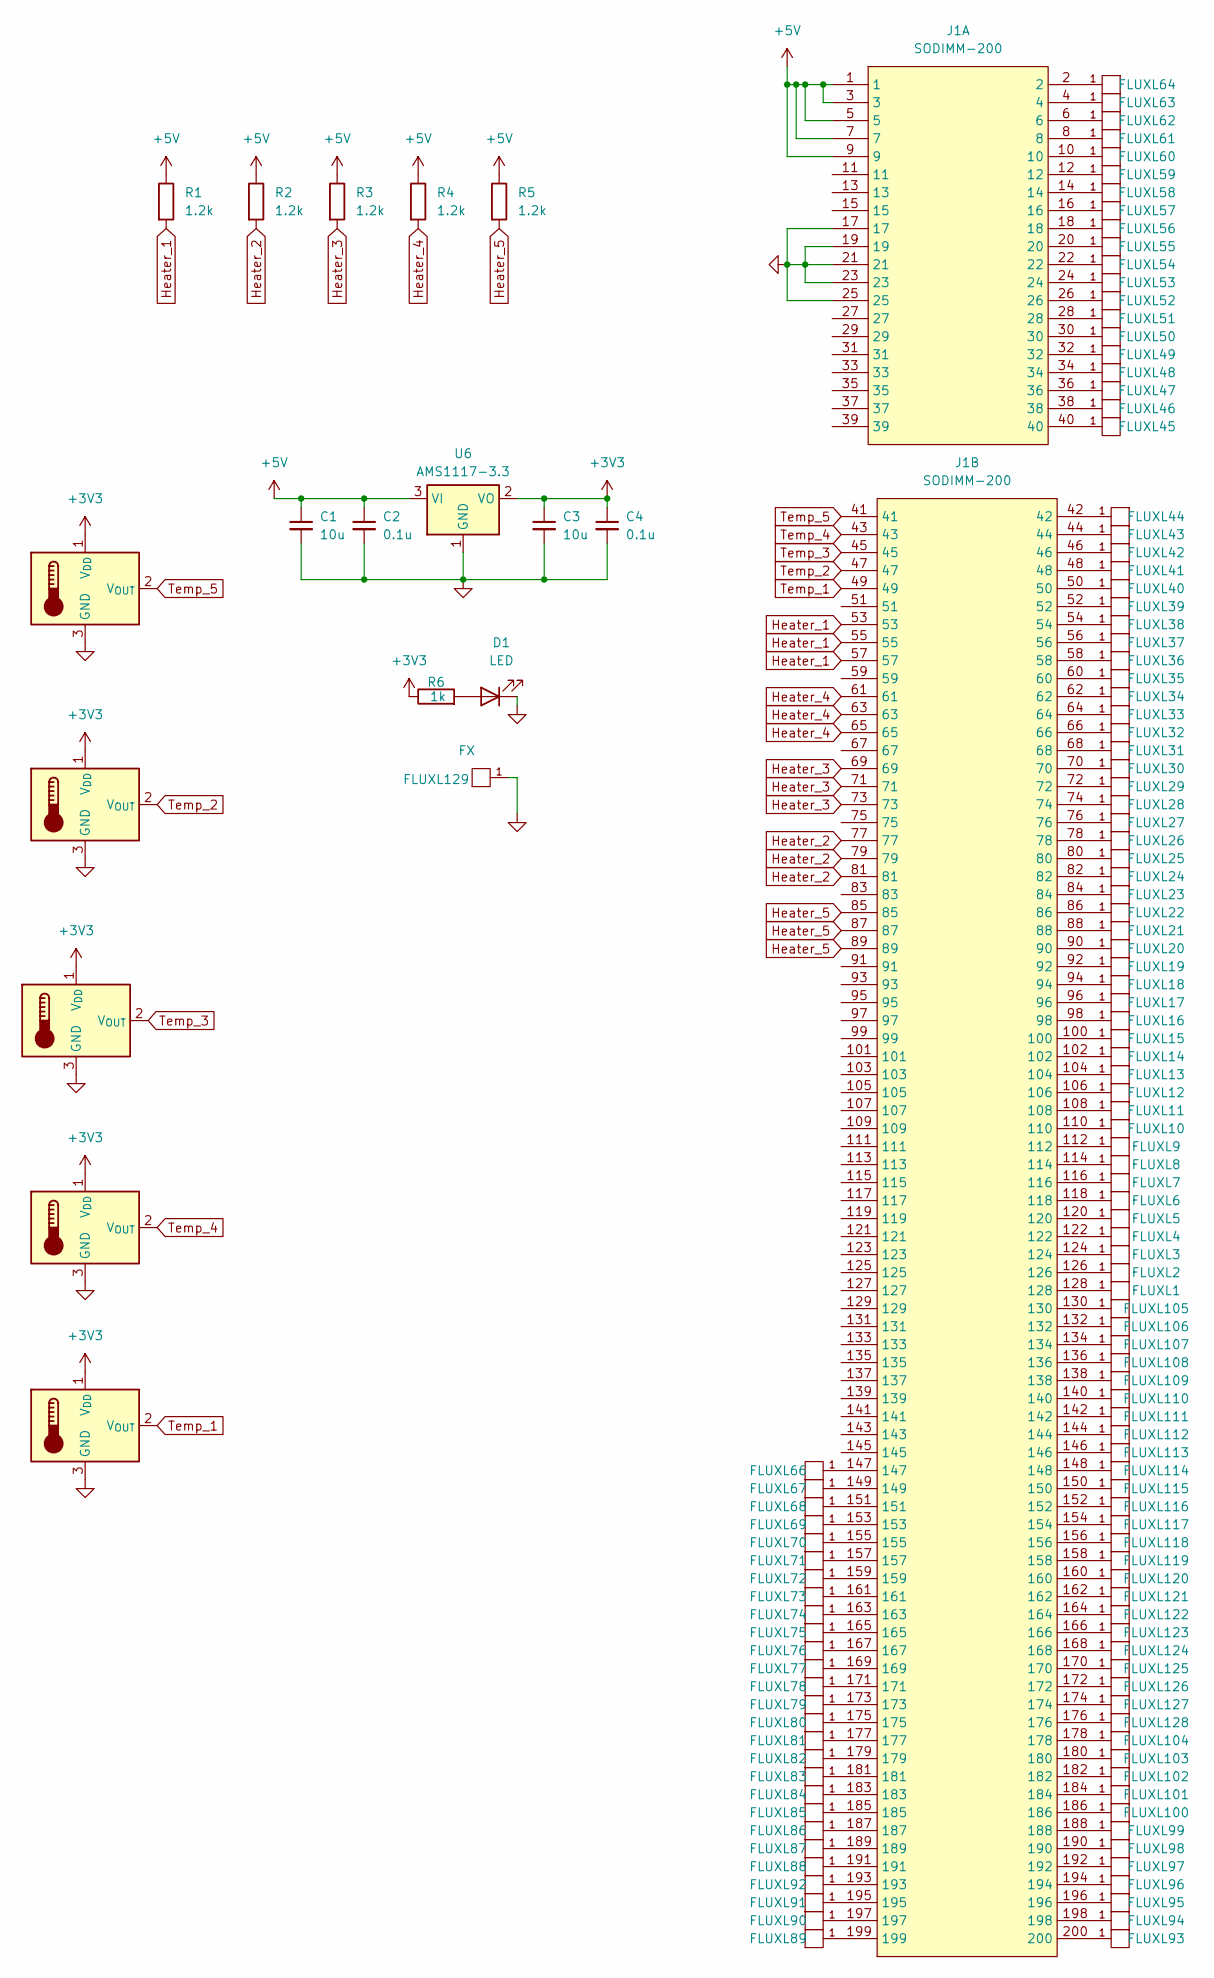
[picture p8: schematic Cartridge.kicad_sch]

Parts:
C1, C3: 10u; C_0402_1005Metric
C2, C4: 0.1u; C_0402_1005Metric
D1: LED; LED_0603_1608Metric
FLUXL1, FLUXL2, FLUXL3, FLUXL4, FLUXL5, FLUXL6, FLUXL7, FLUXL8, FLUXL9, FLUXL10, FLUXL11, FLUXL12, FLUXL13, FLUXL14, FLUXL15, FLUXL16, FLUXL17, FLUXL18, FLUXL19, FLUXL20, FLUXL21, FLUXL22, FLUXL23, FLUXL24, FLUXL25, FLUXL26, FLUXL27, FLUXL28, FLUXL29, FLUXL30, FLUXL31, FLUXL32, FLUXL33, FLUXL34, FLUXL35, FLUXL36, FLUXL37, FLUXL38, FLUXL39, FLUXL40, FLUXL41, FLUXL42, FLUXL43, FLUXL44, FLUXL45, FLUXL46, FLUXL47, FLUXL48, FLUXL49, FLUXL50, FLUXL51, FLUXL52, FLUXL53, FLUXL54, FLUXL55, FLUXL56, FLUXL57, FLUXL58, FLUXL59, FLUXL60, FLUXL61, FLUXL66, FLUXL67, FLUXL68, FLUXL69, FLUXL70, FLUXL71, FLUXL72, FLUXL73, FLUXL74, FLUXL75, FLUXL76, FLUXL77, FLUXL78, FLUXL79, FLUXL80, FLUXL81, FLUXL82, FLUXL83, FLUXL84, FLUXL85, FLUXL86, FLUXL87, FLUXL88, FLUXL89, FLUXL90, FLUXL91, FLUXL92, FLUXL93, FLUXL94, FLUXL95, FLUXL96, FLUXL97, FLUXL98, FLUXL99, FLUXL100, FLUXL101, FLUXL102, FLUXL103, FLUXL104, FLUXL105, FLUXL106, FLUXL107, FLUXL108, FLUXL109, FLUXL110, FLUXL111, FLUXL112, FLUXL113, FLUXL114, FLUXL115, FLUXL116, FLUXL117, FLUXL118, FLUXL119, FLUXL120, FLUXL121, FLUXL122, FLUXL123, FLUXL124, FLUXL125, FLUXL126, FLUXL127, FLUXL128: FX; FLUXPAD_2_75_4MIL_4_5
FLUXL62: FX; FLUXPAD_2_75_4MIL_4_5_res1
FLUXL63: FX; FLUXPAD_2_75_4MIL_4_5_res2
FLUXL64: FX; FLUXPAD_2_75_4MIL_4_5_res3
FLUXL129: FX; Pad_4mm_10mm
J1: SODIMM-200; DDR2
R1, R2, R3, R4, R5: 1.2k; R_1206_3216Metric
R6: 1k; R_0402_1005Metric
U1, U2, U3, U4, U5: MCP9700Ax-ETT; SOT-23
U6: AMS1117-3.3; SOT-223-3_TabPin2

Connections:
+3V3: C3.1, C4.1, R6.1, U1.1 (V_{DD}), U2.1 (V_{DD}), U3.1 (V_{DD}), U4.1 (V_{DD}), U5.1 (V_{DD}), U6.2 (VO)
+5V: C1.1, C2.1, J1.1, J1.3, J1.5, J1.7, J1.9, R1.1, R2.1, R3.1, R4.1, R5.1, U6.3 (VI)
GND: C1.2, C2.2, C3.2, C4.2, D1.1 (K), FLUXL129.1, J1.17, J1.19, J1.21, J1.23, J1.25, U1.3 (GND), U2.3 (GND), U3.3 (GND), U4.3 (GND), U5.3 (GND), U6.1 (GND)
Heater_1: J1.53, J1.55, J1.57, R1.2
Heater_2: J1.77, J1.79, J1.81, R2.2
Heater_3: J1.69, J1.71, J1.73, R3.2
Heater_4: J1.61, J1.63, J1.65, R4.2
Heater_5: J1.85, J1.87, J1.89, R5.2
unnamed: D1.2 (A), R6.2
unnamed: FLUXL1.1, J1.128
unnamed: FLUXL2.1, J1.126
unnamed: FLUXL3.1, J1.124
unnamed: FLUXL4.1, J1.122
unnamed: FLUXL5.1, J1.120
unnamed: FLUXL6.1, J1.118
unnamed: FLUXL7.1, J1.116
unnamed: FLUXL8.1, J1.114
unnamed: FLUXL9.1, J1.112
unnamed: FLUXL10.1, J1.110
unnamed: FLUXL11.1, J1.108
unnamed: FLUXL12.1, J1.106
unnamed: FLUXL13.1, J1.104
unnamed: FLUXL14.1, J1.102
unnamed: FLUXL15.1, J1.100
unnamed: FLUXL16.1, J1.98
unnamed: FLUXL17.1, J1.96
unnamed: FLUXL18.1, J1.94
unnamed: FLUXL19.1, J1.92
unnamed: FLUXL20.1, J1.90
unnamed: FLUXL21.1, J1.88
unnamed: FLUXL22.1, J1.86
unnamed: FLUXL23.1, J1.84
unnamed: FLUXL24.1, J1.82
unnamed: FLUXL25.1, J1.80
unnamed: FLUXL26.1, J1.78
unnamed: FLUXL27.1, J1.76
unnamed: FLUXL28.1, J1.74
unnamed: FLUXL29.1, J1.72
unnamed: FLUXL30.1, J1.70
unnamed: FLUXL31.1, J1.68
unnamed: FLUXL32.1, J1.66
unnamed: FLUXL33.1, J1.64
unnamed: FLUXL34.1, J1.62
unnamed: FLUXL35.1, J1.60
unnamed: FLUXL36.1, J1.58
unnamed: FLUXL37.1, J1.56
unnamed: FLUXL38.1, J1.54
unnamed: FLUXL39.1, J1.52
unnamed: FLUXL40.1, J1.50
unnamed: FLUXL41.1, J1.48
unnamed: FLUXL42.1, J1.46
unnamed: FLUXL43.1, J1.44
unnamed: FLUXL44.1, J1.42
unnamed: FLUXL45.1, J1.40
unnamed: FLUXL46.1, J1.38
unnamed: FLUXL47.1, J1.36
unnamed: FLUXL48.1, J1.34
unnamed: FLUXL49.1, J1.32
unnamed: FLUXL50.1, J1.30
unnamed: FLUXL51.1, J1.28
unnamed: FLUXL52.1, J1.26
unnamed: FLUXL53.1, J1.24
unnamed: FLUXL54.1, J1.22
unnamed: FLUXL55.1, J1.20
unnamed: FLUXL56.1, J1.18
unnamed: FLUXL57.1, J1.16
unnamed: FLUXL58.1, J1.14
unnamed: FLUXL59.1, J1.12
unnamed: FLUXL60.1, J1.10
unnamed: FLUXL61.1, J1.8
unnamed: FLUXL62.1, J1.6
unnamed: FLUXL63.1, J1.4
unnamed: FLUXL64.1, J1.2
unnamed: FLUXL66.1, J1.147
unnamed: FLUXL67.1, J1.149
unnamed: FLUXL68.1, J1.151
unnamed: FLUXL69.1, J1.153
unnamed: FLUXL70.1, J1.155
unnamed: FLUXL71.1, J1.157
unnamed: FLUXL72.1, J1.159
unnamed: FLUXL73.1, J1.161
unnamed: FLUXL74.1, J1.163
unnamed: FLUXL75.1, J1.165
unnamed: FLUXL76.1, J1.167
unnamed: FLUXL77.1, J1.169
unnamed: FLUXL78.1, J1.171
unnamed: FLUXL79.1, J1.173
unnamed: FLUXL80.1, J1.175
unnamed: FLUXL81.1, J1.177
unnamed: FLUXL82.1, J1.179
unnamed: FLUXL83.1, J1.181
unnamed: FLUXL84.1, J1.183
unnamed: FLUXL85.1, J1.185
unnamed: FLUXL86.1, J1.187
unnamed: FLUXL87.1, J1.189
unnamed: FLUXL88.1, J1.191
unnamed: FLUXL89.1, J1.199
unnamed: FLUXL90.1, J1.197
unnamed: FLUXL91.1, J1.195
unnamed: FLUXL92.1, J1.193
unnamed: FLUXL93.1, J1.200
unnamed: FLUXL94.1, J1.198
unnamed: FLUXL95.1, J1.196
unnamed: FLUXL96.1, J1.194
unnamed: FLUXL97.1, J1.192
unnamed: FLUXL98.1, J1.190
unnamed: FLUXL99.1, J1.188
unnamed: FLUXL100.1, J1.186
unnamed: FLUXL101.1, J1.184
unnamed: FLUXL102.1, J1.182
unnamed: FLUXL103.1, J1.180
unnamed: FLUXL104.1, J1.178
unnamed: FLUXL105.1, J1.130
unnamed: FLUXL106.1, J1.132
unnamed: FLUXL107.1, J1.134
unnamed: FLUXL108.1, J1.136
unnamed: FLUXL109.1, J1.138
unnamed: FLUXL110.1, J1.140
unnamed: FLUXL111.1, J1.142
unnamed: FLUXL112.1, J1.144
unnamed: FLUXL113.1, J1.146
unnamed: FLUXL114.1, J1.148
unnamed: FLUXL115.1, J1.150
unnamed: FLUXL116.1, J1.152
unnamed: FLUXL117.1, J1.154
unnamed: FLUXL118.1, J1.156
unnamed: FLUXL119.1, J1.158
unnamed: FLUXL120.1, J1.160
unnamed: FLUXL121.1, J1.162
unnamed: FLUXL122.1, J1.164
unnamed: FLUXL123.1, J1.166
unnamed: FLUXL124.1, J1.168
unnamed: FLUXL125.1, J1.170
unnamed: FLUXL126.1, J1.172
unnamed: FLUXL127.1, J1.174
unnamed: FLUXL128.1, J1.176
Temp_1: J1.49, U5.2 (V_{OUT})
Temp_2: J1.47, U2.2 (V_{OUT})
Temp_3: J1.45, U3.2 (V_{OUT})
Temp_4: J1.43, U4.2 (V_{OUT})
Temp_5: J1.41, U1.2 (V_{OUT})

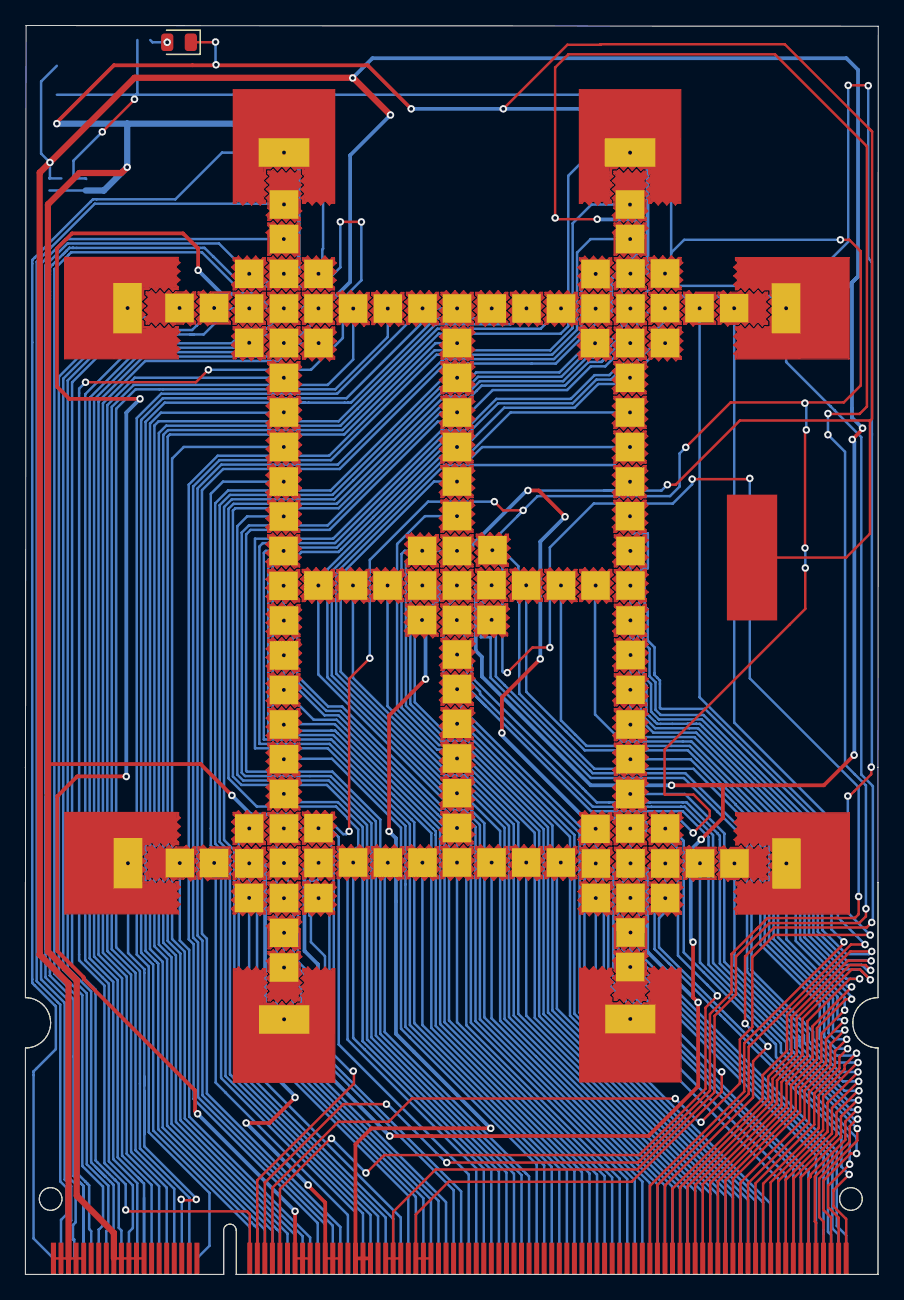
[picture p9: board Cartridge.kicad_pcb from above]

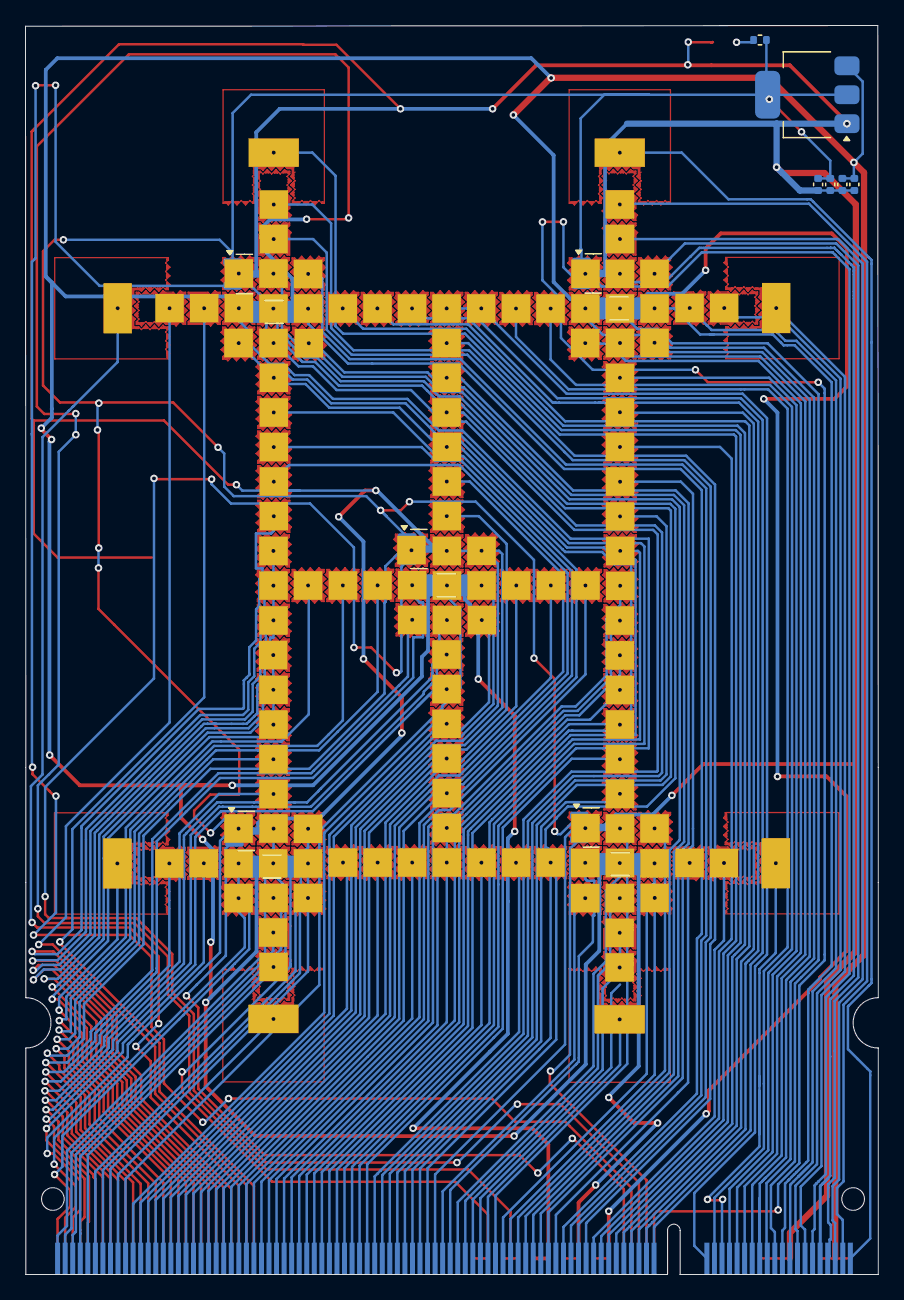
[picture p10: board Cartridge.kicad_pcb from below]

Board: 2 copper layers, 67.8 x 99.3 mm, 146 parts (16 on the bottom side), 141 nets.
